vooon/miniecu/README.md

miniECU
=======

miniECU - monitoring unit for model gasoline engines with kill switch.

TBD
