vooon/miniecu/tests/readme.md

Test data
=========

Flow test
---------

Tested on water, 10 cm^3 with two different height.
Time for h1: ~12 sec, h2: ~9 sec.

Calculated flow: 10/12 = 0.8(3) ml/s & 10/9 = 1.1(1) ml/s
