vooon/miniecu/tests/flow_h1_1.csv

# Date: 2014-10-31 10:39:24 | Name: flow test 1
engine_id | system_time | timestamp_ms | status | rpm | battery.voltage | battery.current | battery.remaining | temperature.engine1 | temperature.engine2 | time.total_elapsed | time.current_powered | cpu.load | cpu.temperature | cpu.rtc_vbat | fuel.flow_ml | fuel.total_used_ml | fuel.remaining | adc_raw.flt_temp | adc_raw.flt_oilp | adc_raw.flt_flow | adc_raw.flt_vbat | adc_raw.flt_vrtc | adc_raw.raw_temp | adc_raw.raw_oilp | adc_raw.raw_flow | adc_raw.raw_vbat | adc_raw.raw_vrtc
1 | 517 | NaN | 0 | 0 | 4992 | NaN | 98 | 22913 | NaN | 0 | 0 | NaN | 25270 | NaN | 0 | 0 | NaN | 1.7287009954452515 | 3.3008718490600586 | 0.7941491007804871 | 4.592803001403809 | 7.700487913098186e-06 | 1.7285282611846924 | 3.2999496459960938 | 0.8032090067863464 | 4.5891828536987305 | 0.0
1 | 619 | NaN | 0 | 0 | 5006 | NaN | 100 | 22911 | NaN | 0 | 0 | NaN | 25317 | NaN | 0 | 0 | NaN | 1.7287904024124146 | 3.3008718490600586 | 0.7945593595504761 | 4.606296062469482 | 3.43914272060708e-11 | 1.729837417602539 | 3.2999496459960938 | 0.8032593131065369 | 4.629214763641357 | 0.0
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
