vooon/miniecu/tests/flow_h1_2.csv

# Date: 2014-10-31 10:40:57 | Name: flow test 2
engine_id | system_time | timestamp_ms | status | rpm | battery.voltage | battery.current | battery.remaining | temperature.engine1 | temperature.engine2 | time.total_elapsed | time.current_powered | cpu.load | cpu.temperature | cpu.rtc_vbat | fuel.flow_ml | fuel.total_used_ml | fuel.remaining | adc_raw.flt_temp | adc_raw.flt_oilp | adc_raw.flt_flow | adc_raw.flt_vbat | adc_raw.flt_vrtc | adc_raw.raw_temp | adc_raw.raw_oilp | adc_raw.raw_flow | adc_raw.raw_vbat | adc_raw.raw_vrtc
1 | 102968 | NaN | 0 | 0 | 5026 | NaN | 100 | 22790 | NaN | 0 | 0 | NaN | 35627 | NaN | 0 | 0 | NaN | 1.7334024906158447 | 3.300661563873291 | 0.6732372045516968 | 4.626361846923828 | 8.529740114227025e-08 | 1.7333623170852661 | 3.2999496459960938 | 0.6949462294578552 | 4.622265815734863 | 0.0
1 | 103070 | NaN | 0 | 0 | 5028 | NaN | 100 | 22791 | NaN | 0 | 0 | NaN | 35614 | NaN | 160667 | 0 | NaN | 1.733271837234497 | 3.3006627559661865 | 0.8349511027336121 | 4.628504276275635 | -1.3289600353743313e-17 | 1.7342686653137207 | 3.2999496459960938 | 0.8580453395843506 | 4.594168186187744 | 0.0
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
