vooon/miniecu/tests/flow_h1_3.csv

# Date: 2014-10-31 10:42:09 | Name: flow test 3
engine_id | system_time | timestamp_ms | status | rpm | battery.voltage | battery.current | battery.remaining | temperature.engine1 | temperature.engine2 | time.total_elapsed | time.current_powered | cpu.load | cpu.temperature | cpu.rtc_vbat | fuel.flow_ml | fuel.total_used_ml | fuel.remaining | adc_raw.flt_temp | adc_raw.flt_oilp | adc_raw.flt_flow | adc_raw.flt_vbat | adc_raw.flt_vrtc | adc_raw.raw_temp | adc_raw.raw_oilp | adc_raw.raw_flow | adc_raw.raw_vbat | adc_raw.raw_vrtc
1 | 157945 | NaN | 0 | 0 | 5027 | NaN | 100 | 22623 | NaN | 0 | 0 | NaN | 36032 | NaN | 0 | 0 | NaN | 1.7396252155303955 | 3.300663471221924 | 0.7051165699958801 | 4.627535343170166 | 1.8904756296201318e-17 | 1.737994909286499 | 3.2999496459960938 | 0.6789333820343018 | 4.623776435852051 | 0.0
1 | 158046 | NaN | 0 | 0 | 4992 | NaN | 98 | 22633 | NaN | 0 | 0 | NaN | 36155 | NaN | 251837 | 0 | NaN | 1.7392842769622803 | 3.300663471221924 | 0.881591260433197 | 4.592129707336426 | -3.1687468675465486e-15 | 1.7371388673782349 | 3.2999496459960938 | 0.8919340372085571 | 4.586312770843506 | 0.0
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
