vooon/miniecu/tests/flow_h2_1.csv

# Date: 2014-10-31 10:43:16 | Name: flow test h2 1
engine_id | system_time | timestamp_ms | status | rpm | battery.voltage | battery.current | battery.remaining | temperature.engine1 | temperature.engine2 | time.total_elapsed | time.current_powered | cpu.load | cpu.temperature | cpu.rtc_vbat | fuel.flow_ml | fuel.total_used_ml | fuel.remaining | adc_raw.flt_temp | adc_raw.flt_oilp | adc_raw.flt_flow | adc_raw.flt_vbat | adc_raw.flt_vrtc | adc_raw.raw_temp | adc_raw.raw_oilp | adc_raw.raw_flow | adc_raw.raw_vbat | adc_raw.raw_vrtc
1 | 215214 | NaN | 0 | 0 | 5032 | NaN | 100 | 22598 | NaN | 0 | 0 | NaN | 36187 | NaN | 566455 | 0 | NaN | 1.740506649017334 | 3.30065655708313 | 1.2237610816955566 | 4.632783889770508 | 1.0591588370245653e-11 | 1.7414190769195557 | 3.2999496459960938 | 1.1835888624191284 | 4.633293628692627 | 0.0
1 | 215316 | NaN | 0 | 0 | 5007 | NaN | 100 | 22602 | NaN | 0 | 0 | NaN | 36224 | NaN | 489495 | 0 | NaN | 1.7402788400650024 | 3.300661563873291 | 1.1306991577148438 | 4.6070237159729 | 4.3517224546096855e-11 | 1.7406134605407715 | 3.2999496459960938 | 1.1182284355163574 | 4.59930419921875 | 0.0
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
