vooon/miniecu/tests/flow_h2_2.csv

# Date: 2014-10-31 10:44:24 | Name: flow test h2 2
engine_id | system_time | timestamp_ms | status | rpm | battery.voltage | battery.current | battery.remaining | temperature.engine1 | temperature.engine2 | time.total_elapsed | time.current_powered | cpu.load | cpu.temperature | cpu.rtc_vbat | fuel.flow_ml | fuel.total_used_ml | fuel.remaining | adc_raw.flt_temp | adc_raw.flt_oilp | adc_raw.flt_flow | adc_raw.flt_vbat | adc_raw.flt_vrtc | adc_raw.raw_temp | adc_raw.raw_oilp | adc_raw.raw_flow | adc_raw.raw_vbat | adc_raw.raw_vrtc
1 | 286735 | NaN | 0 | 0 | 4994 | NaN | 98 | 22613 | NaN | 0 | 0 | NaN | 35937 | NaN | 0 | 0 | NaN | 1.739984393119812 | 3.300666570663452 | 0.7632520794868469 | 4.594229221343994 | 1.431556739817097e-07 | 1.7410162687301636 | 3.2999496459960938 | 0.7833691835403442 | 4.597038269042969 | 0.0
1 | 286836 | NaN | 0 | 0 | 4996 | NaN | 99 | 22613 | NaN | 0 | 0 | NaN | 35957 | NaN | 0 | 0 | NaN | 1.7399955987930298 | 3.300658702850342 | 0.7743771076202393 | 4.596792697906494 | 3.2031418262159356e-14 | 1.741117000579834 | 3.2999496459960938 | 0.7913756370544434 | 4.597944736480713 | 0.0
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
