vooon/miniecu/tests/flow_h2_3.csv

# Date: 2014-10-31 10:45:27 | Name: flow test h2 3
engine_id | system_time | timestamp_ms | status | rpm | battery.voltage | battery.current | battery.remaining | temperature.engine1 | temperature.engine2 | time.total_elapsed | time.current_powered | cpu.load | cpu.temperature | cpu.rtc_vbat | fuel.flow_ml | fuel.total_used_ml | fuel.remaining | adc_raw.flt_temp | adc_raw.flt_oilp | adc_raw.flt_flow | adc_raw.flt_vbat | adc_raw.flt_vrtc | adc_raw.raw_temp | adc_raw.raw_oilp | adc_raw.raw_flow | adc_raw.raw_vbat | adc_raw.raw_vrtc
1 | 349792 | NaN | 0 | 0 | 4991 | NaN | 97 | 22720 | NaN | 0 | 0 | NaN | 36045 | NaN | 268119 | 0 | NaN | 1.7359936237335205 | 3.3006627559661865 | 0.8907217979431152 | 4.591337203979492 | 1.2534493976090744e-07 | 1.7357792854309082 | 3.2999496459960938 | 0.9075440168380737 | 4.587521076202393 | 0.0016117215855047107
1 | 349894 | NaN | 0 | 0 | 5028 | NaN | 100 | 22712 | NaN | 0 | 0 | NaN | 35876 | NaN | 225253 | 0 | NaN | 1.7363635301589966 | 3.3006603717803955 | 0.8933573961257935 | 4.628243923187256 | 1.0359529206693807e-11 | 1.736585021018982 | 3.2999496459960938 | 0.8858914971351624 | 4.62589168548584 | 0.0
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
