vooon/miniecu/doc/gtkgauge-test.png

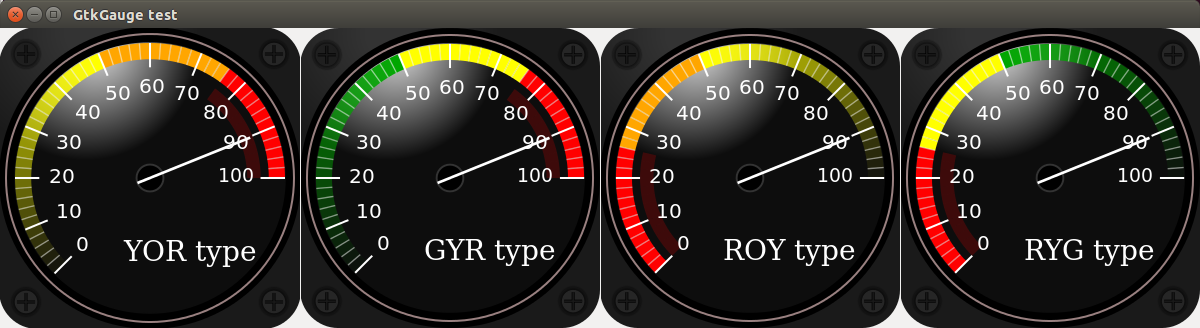
doc/gtkgauge-test.png
