vooon/miniecu/hw/release/miniecu-v2.0a.brd

## EAGLE design hw/release/miniecu-v2.0a.brd (2014-03-09)

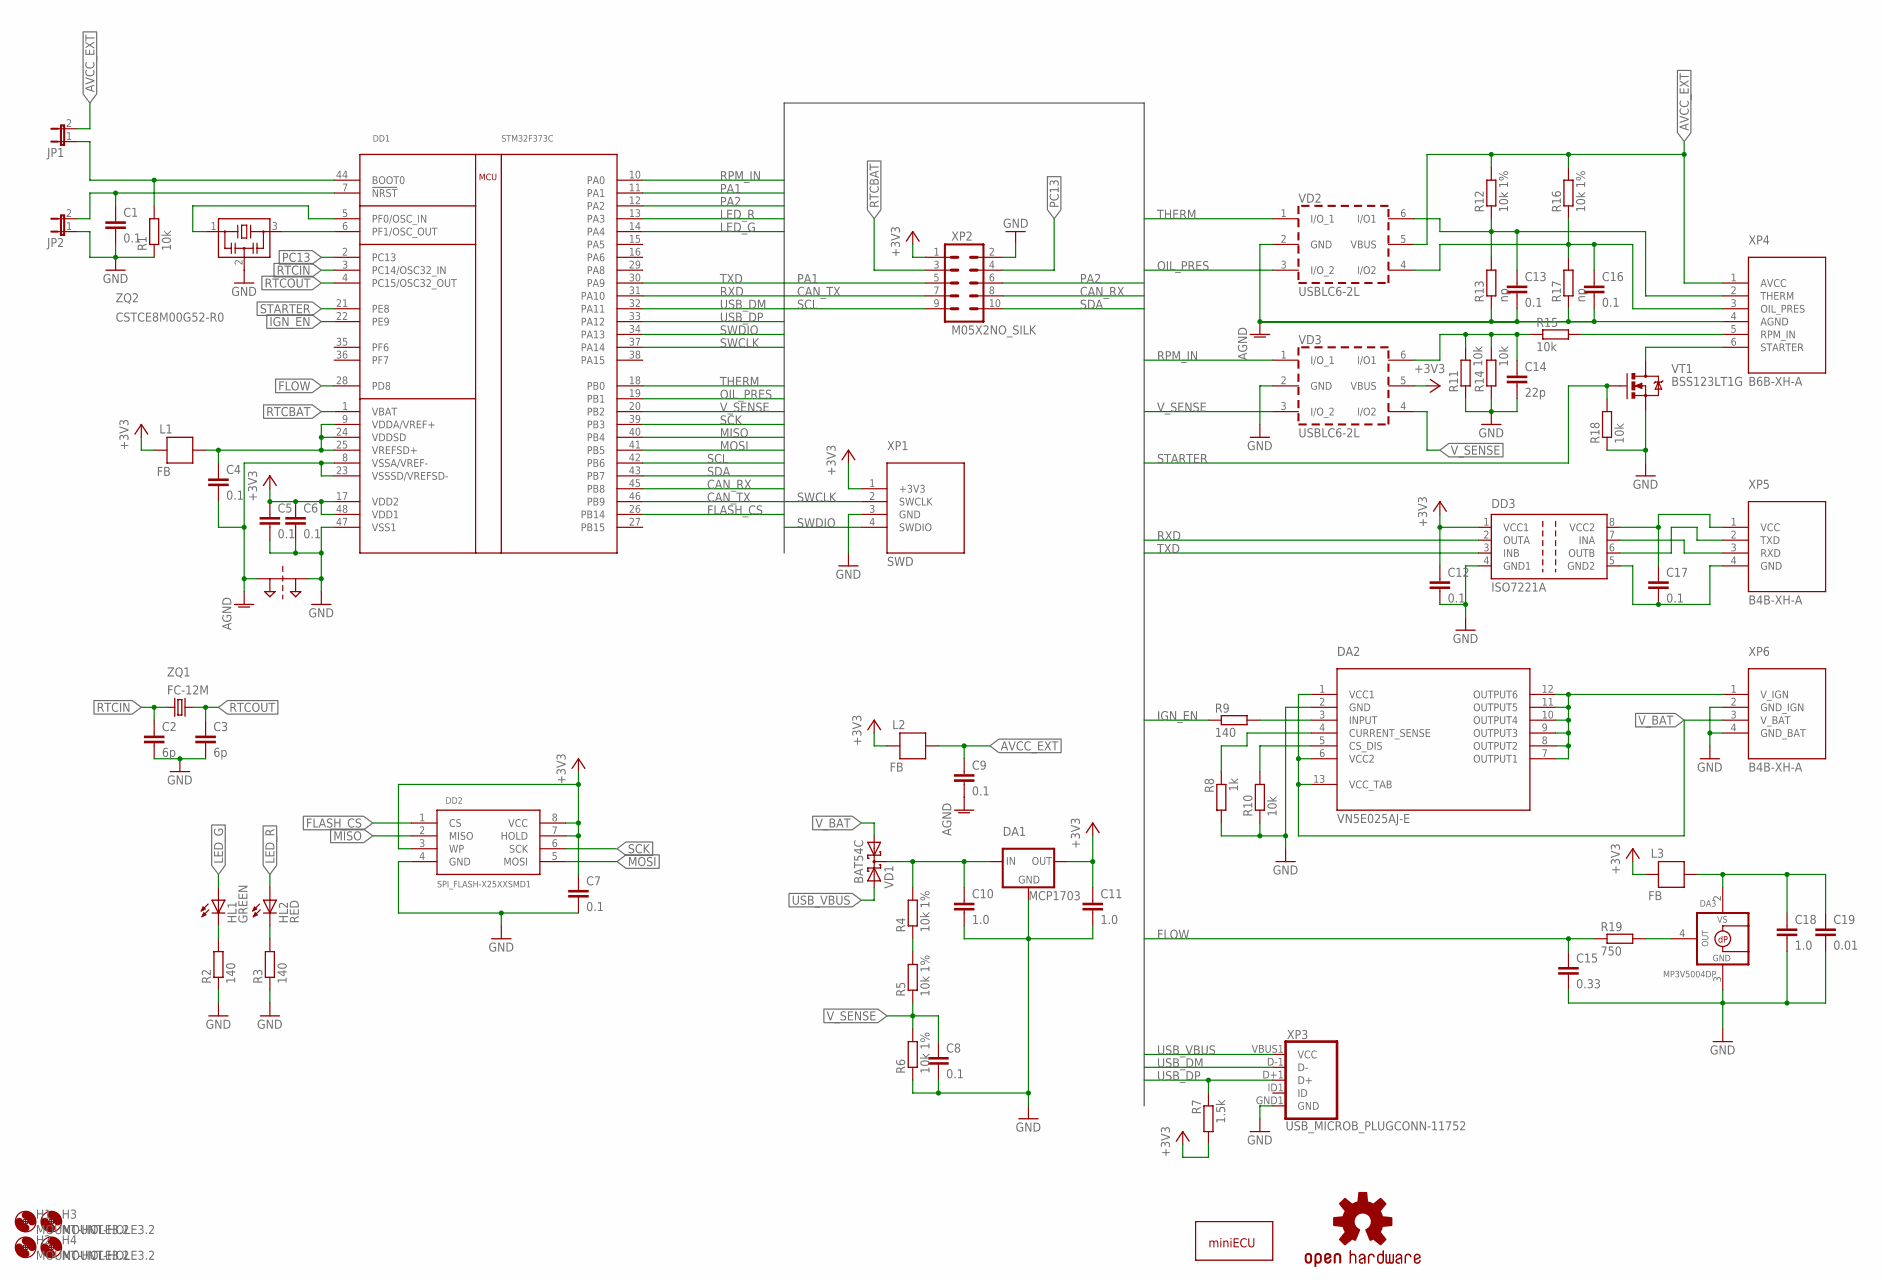
[picture p2: schematic miniecu-v2.0a.sch]

Parts:
C1, C4, C5, C6, C7, C8, C9, C12, C13, C16, C17: 0.1; C0603
C2, C3: 6p; C0603
C10, C11, C18: 1.0; C0805
C14: 22p; C0603
C15: 0.33; C0603
C19: 0.01; C0603
DA1: MCP1703; SOT23
DA2: VN5E025AJ-E; POWERSSO-12
DA3: MP3V5004DP; SOP8-1351
DD1: STM32F373C; LQFP48
DD2: SPI_FLASH-X25XXSMD1; SO08-EIAJ
DD3: ISO7221A; SO-08
H1, H2, H3, H4: MOUNT-HOLE3.2; 3,2
HL1: GREEN; LED-0603
HL2: RED; LED-0603
JP1, JP2: JUMPER-2SMD-NO; SJ_2S-NO
L1, L2, L3: FB; 0603
LOGO1: MINIECU_LOGO
LOGO2: OSHW-LOGOL; OSHW-LOGO-L
PT1: 2PT_GND_TIE
R1, R10, R11, R14, R15, R18: 10k; R0603
R2, R3, R9: 140; R0603
R4, R5, R6, R12, R16: 10k 1%; R0805
R7: 1.5k; R0603
R8: 1k; R0603
R13, R17: np; R0805
R19: 750; R0603
VD1: BAT54C; SOT23
VD2, VD3: USBLC6-2L; SOT-23-6L
VT1: BSS123LT1G; SOT23
XP1: SWD; 1X04-1.27MM
XP2: M05X2NO_SILK; 2X5_NOSILK
XP3: USB_MICROB_PLUGCONN-11752; USB-B-MICRO-SMD_V03
XP4: B6B-XH-A; B6B-XH
XP5, XP6: B4B-XH-A; B4B-XH
ZQ1: FC-12M
ZQ2: CSTCE8M00G52-R0; CSTCE

Connections:
!NRST: C1.1, DD1.7 (!NRST), JP2.2
+3V3: C5.1, C6.1, C7.1, C11.1, C12.1, DA1.2 (OUT), DD1.17 (VDD2), DD1.48 (VDD1), DD2.3 (WP), DD2.7 (HOLD), DD2.8 (VCC), DD3.1 (VCC1), L1.2, L2.2, L3.2, R7.2, VD3.5 (VBUS), XP1.1 (+3V3), XP2.1
AGND: C4.2, C9.2, C13.2, C16.2, DD1.8 (VSSA/VREF-), DD1.23 (VSSSD/VREFSD-), PT1.P$1, R13.1, R17.1, VD2.2 (GND), XP4.4 (AGND)
AVCC: C4.1, DD1.9 (VDDA/VREF+), DD1.24 (VDDSD), DD1.25 (VREFSD+), L1.1
AVCC_EXT: C9.1, JP1.2, L2.1, R12.2, R16.2, VD2.5 (VBUS), XP4.1 (AVCC)
AVCC_FLOW: C18.1, C19.1, DA3.2 (VS), L3.1
BOOT0: DD1.44 (BOOT0), JP1.1, R1.2
CAN_RX: DD1.45 (PB8), XP2.8
CAN_TX: DD1.46 (PB9), XP2.7
FLASH_CS: DD1.26 (PB14), DD2.1 (CS)
FLOW: C15.1, DD1.28 (PD8), R19.1
GND: C1.2, C2.2, C3.2, C5.2, C6.2, C7.2, C8.2, C10.2, C11.2, C12.2, C14.2, C15.2, C18.2, C19.2, DA1.1 (GND), DA2.2 (GND), DA3.3 (GND), DD1.47 (VSS1), DD2.4 (GND), DD3.4 (GND1), JP2.1, PT1.P$2, R1.1, R2.1, R3.1, R6.1, R8.2, R10.1, R11.1, R14.1, R18.1, VD3.2 (GND), VT1.2 (S), XP1.3 (GND), XP2.2, XP3.GND1 (GND), XP6.2 (GND_IGN), XP6.4 (GND_BAT), ZQ2.2
GND2: C17.2, DD3.5 (GND2), XP5.4 (GND)
IGN_EN: DD1.22 (PE9), R9.1
IORXD: DD3.7 (INA), XP5.3 (RXD)
IOTXD: DD3.6 (OUTB), XP5.2 (TXD)
LED_G: DD1.14 (PA4), HL1.A
LED_R: DD1.13 (PA3), HL2.A
MISO: DD1.40 (PB4), DD2.2 (MISO)
MOSI: DD1.41 (PB5), DD2.5 (MOSI)
unnamed: R4.1, R5.2
unnamed: DA2.4 (CURRENT_SENSE), R8.1
unnamed: HL2.C, R3.2
unnamed: DA3.4 (+VOUT), R19.2
unnamed: HL1.C, R2.2
unnamed: C10.1, DA1.3 (IN), R4.2, VD1.3 (CC)
unnamed: DA2.3 (INPUT), R9.2
unnamed: DA2.5 (CS_DIS), R10.2
OIL_PRES: C16.1, DD1.19 (PB1), R16.1, R17.2, VD2.3 (I/O_2), VD2.4 (I/O2), XP4.3 (OIL_PRES)
OSC_IN: DD1.5 (PF0/OSC_IN), ZQ2.1
OSC_OUT: DD1.6 (PF1/OSC_OUT), ZQ2.3
PA1: DD1.11 (PA1), XP2.5
PA2: DD1.12 (PA2), XP2.6
PC13: DD1.2 (PC13), XP2.4
RPM_IN: C14.1, DD1.10 (PA0), R11.2, R14.2, R15.1, VD3.1 (I/O_1), VD3.6 (I/O1)
RPM_IN_CON: R15.2, XP4.5 (RPM_IN)
RTCBAT: DD1.1 (VBAT), XP2.3
RTCIN: C2.1, DD1.3 (PC14/OSC32_IN), ZQ1.1
RTCOUT: C3.1, DD1.4 (PC15/OSC32_OUT), ZQ1.2
RXD: DD1.31 (PA10), DD3.2 (OUTA)
SCK: DD1.39 (PB3), DD2.6 (SCK)
SCL: DD1.42 (PB6), XP2.9
SDA: DD1.43 (PB7), XP2.10
STARTER: DD1.21 (PE8), R18.2, VT1.1 (G)
STARTER_OUT: VT1.3 (D), XP4.6 (STARTER)
SWCLK: DD1.37 (PA14), XP1.2 (SWCLK)
SWDIO: DD1.34 (PA13), XP1.4 (SWDIO)
THERM: C13.1, DD1.18 (PB0), R12.1, R13.2, VD2.1 (I/O_1), VD2.6 (I/O1), XP4.2 (THERM)
TXD: DD1.30 (PA9), DD3.3 (INB)
USB_DM: DD1.32 (PA11), XP3.D-1 (D-)
USB_DP: DD1.33 (PA12), R7.1, XP3.D+1 (D+)
USB_VBUS: VD1.2 (A2), XP3.VBUS1 (VCC)
VCC2: C17.1, DD3.8 (VCC2), XP5.1 (VCC)
V_BAT: DA2.1 (VCC1), DA2.6 (VCC2), DA2.13 (VCC_TAB), VD1.1 (A1), XP6.3 (V_BAT)
V_IGN: DA2.7 (OUTPUT1), DA2.8 (OUTPUT2), DA2.9 (OUTPUT3), DA2.10 (OUTPUT4), DA2.11 (OUTPUT5), DA2.12 (OUTPUT6), XP6.1 (V_IGN)
V_SENSE: C8.1, DD1.20 (PB2), R5.1, R6.2, VD3.3 (I/O_2), VD3.4 (I/O2)

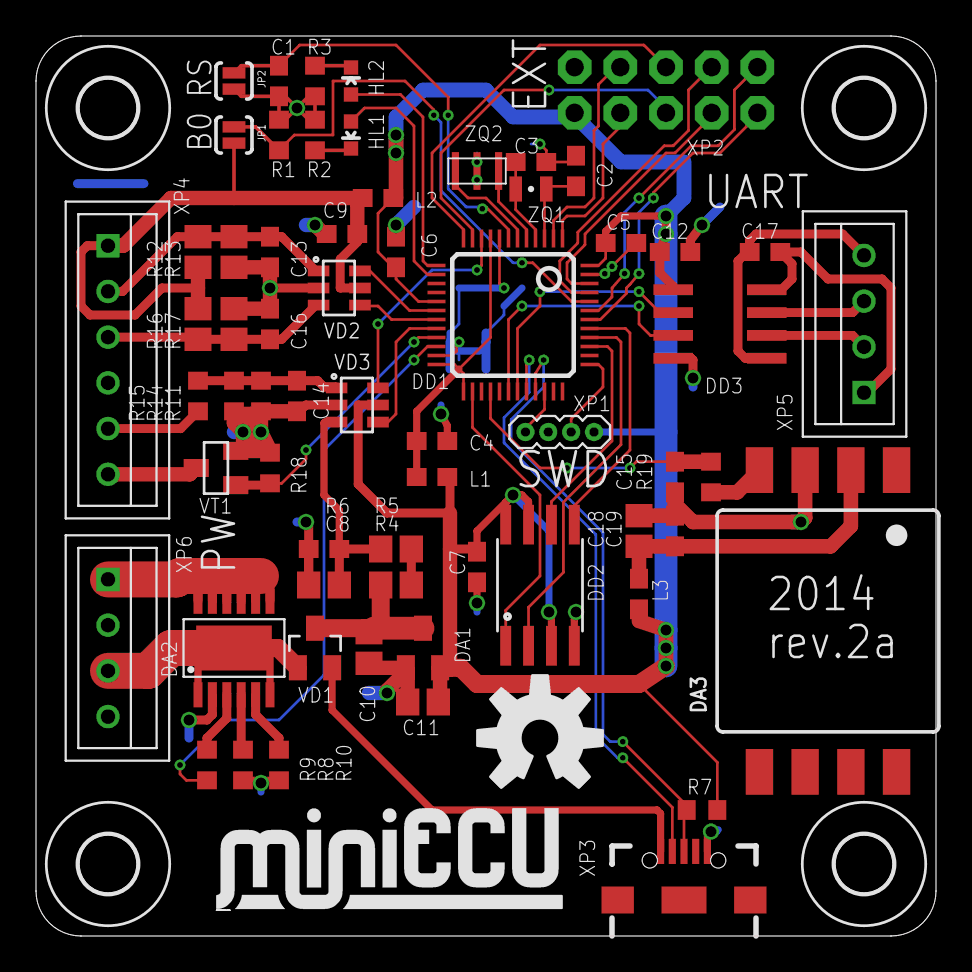
[picture p3: board miniecu-v2.0a.brd from above]

Board: 2 copper layers, 50.0 x 50.0 mm, 70 parts (1 on the bottom side), 56 nets.
