vooon/miniecu/hw/release/miniecu-v1.0c.brd

## EAGLE design hw/release/miniecu-v1.0c.brd (2014-01-30)

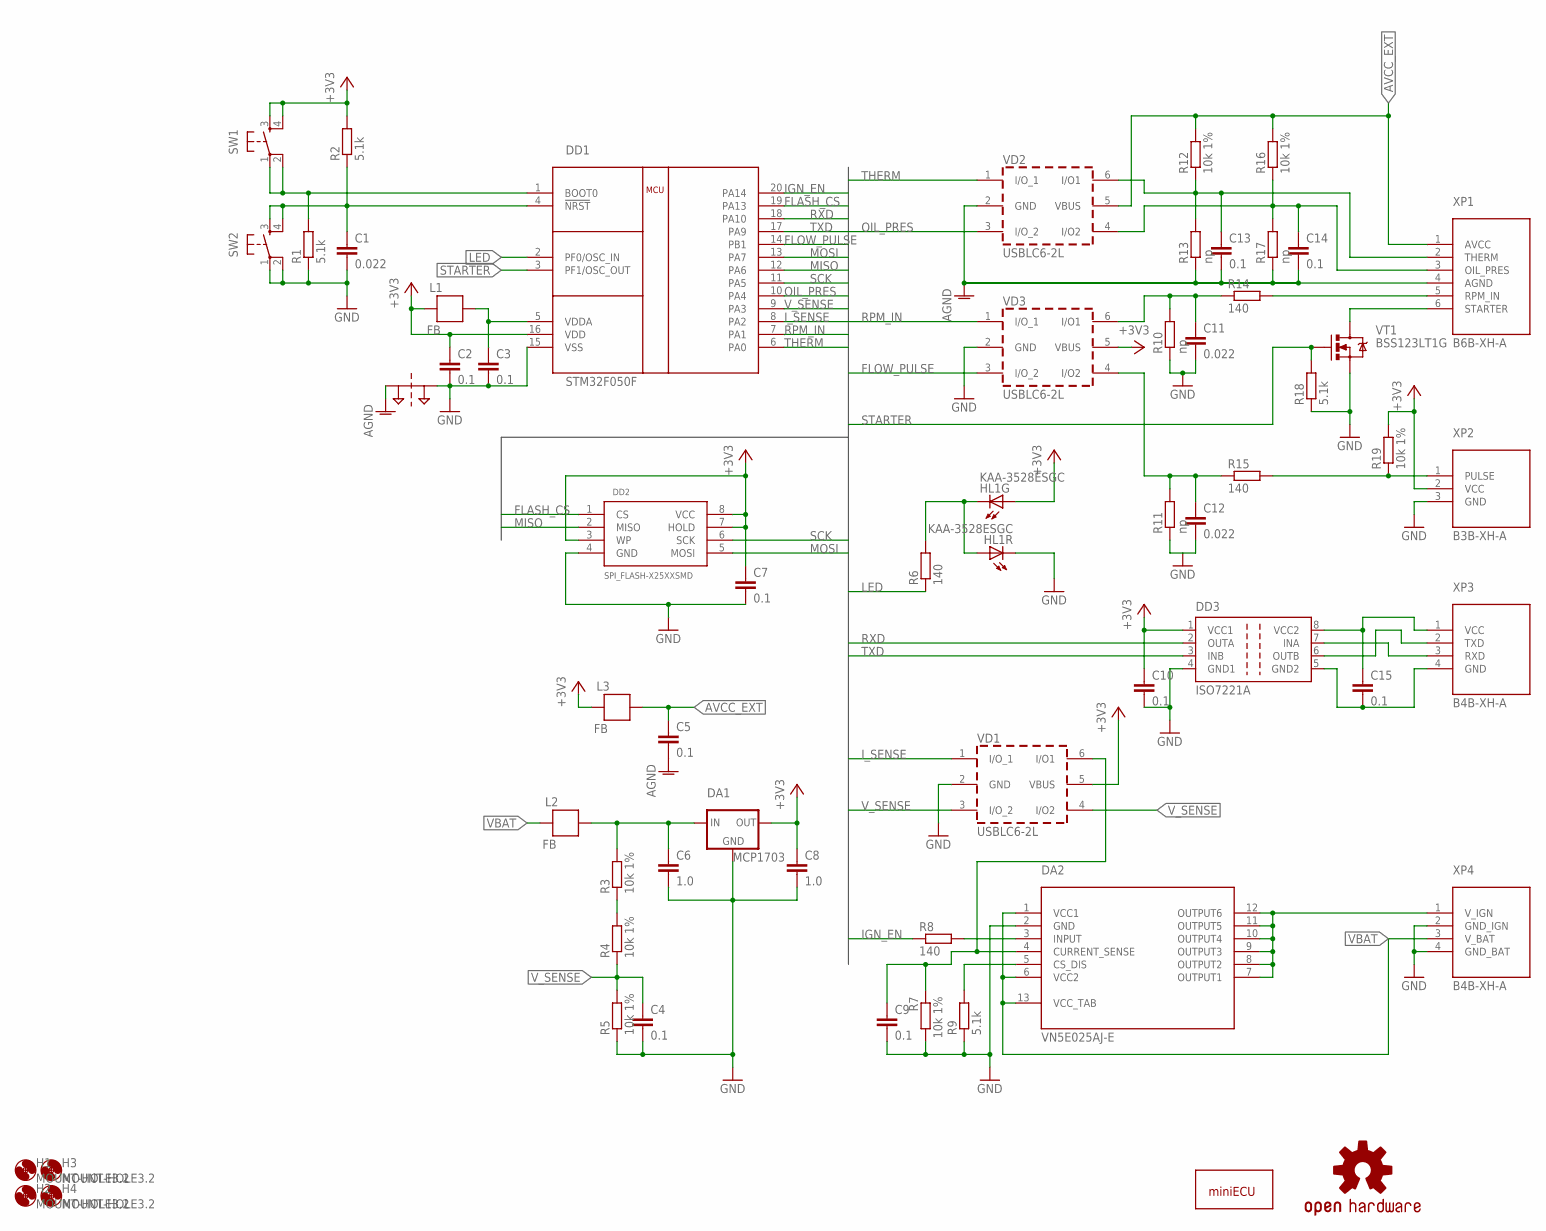
[picture p4: schematic miniecu-v1.0c.sch]

Parts:
C1, C11, C12: 0.022; C0603
C2, C3, C4, C5, C7, C9, C10, C13, C14, C15: 0.1; C0603
C6, C8: 1.0; C0805
DA1: MCP1703; SOT23
DA2: VN5E025AJ-E; POWERSSO-12
DD1: STM32F050F; TSSOP20
DD2: SPI_FLASH-X25XXSMD; SO08
DD3: ISO7221A; SO-08
H1, H2, H3, H4: MOUNT-HOLE3.2; 3,2
HL1: KAA-3528ESGC; KA-3528
L1, L2, L3: FB; 0603
LOGO1: OSHW-LOGOL; OSHW-LOGO-L
LOGO2: MINIECU_LOGO
PT1: 2PT_GND_TIE
R1, R2, R9, R18: 5.1k; R0603
R3, R4, R5, R7, R12, R16, R19: 10k 1%; R0805
R6, R8, R14, R15: 140; R0603
R10, R11: np; R0603
R13, R17: np; R0805
SW1, SW2: TAC_SWITCHSMD; TACTILE_SWITCH_SMD
VD1, VD2, VD3: USBLC6-2L; SOT-23-6L
VT1: BSS123LT1G; SOT23
XP1: B6B-XH-A; B6B-XH
XP2: B3B-XH-A; B3B-XH
XP3, XP4: B4B-XH-A; B4B-XH

Connections:
!NRST: C1.1, DD1.4 (!NRST), R2.1, SW2.3, SW2.4
+3V3: C2.1, C7.1, C8.1, C10.1, DA1.2 (OUT), DD1.16 (VDD), DD2.3 (WP), DD2.7 (HOLD), DD2.8 (VCC), DD3.1 (VCC1), HL1.4 (A), L1.2, L3.2, R2.2, R19.2, SW1.3, SW1.4, VD1.5 (VBUS), VD3.5 (VBUS), XP2.2 (VCC)
AGND: C5.2, C13.2, C14.2, PT1.P$1, R13.1, R17.1, VD2.2 (GND), XP1.4 (AGND)
AVCC: C3.1, DD1.5 (VDDA), L1.1
AVCC_EXT: C5.1, L3.1, R12.2, R16.2, VD2.5 (VBUS), XP1.1 (AVCC)
BOOT0: DD1.1 (BOOT0), R1.2, SW1.1, SW1.2
FLASH_CS: DD1.19 (PA13), DD2.1 (CS)
FLOW_PULSE: C12.1, DD1.14 (PB1), R11.2, R15.1, VD3.3 (I/O_2), VD3.4 (I/O2)
GND: C1.2, C2.2, C3.2, C4.2, C6.2, C7.2, C8.2, C9.2, C10.2, C11.2, C12.2, DA1.1 (GND), DA2.2 (GND), DD1.15 (VSS), DD2.4 (GND), DD3.4 (GND1), HL1.1 (C), PT1.P$2, R1.1, R5.1, R7.2, R9.1, R10.1, R11.1, R18.1, SW2.1, SW2.2, VD1.2 (GND), VD3.2 (GND), VT1.2 (S), XP2.3 (GND), XP4.2 (GND_IGN), XP4.4 (GND_BAT)
GND2: C15.2, DD3.5 (GND2), XP3.4 (GND)
IGN_EN: DD1.20 (PA14), R8.1
IORXD: DD3.7 (INA), XP3.3 (RXD)
IOTXD: DD3.6 (OUTB), XP3.2 (TXD)
I_SENSE: C9.1, DA2.4 (CURRENT_SENSE), DD1.8 (PA2), R7.1, VD1.1 (I/O_1), VD1.6 (I/O1)
LED: DD1.2 (PF0/OSC_IN), R6.1
MISO: DD1.12 (PA6), DD2.2 (MISO)
MOSI: DD1.13 (PA7), DD2.5 (MOSI)
unnamed: R3.1, R4.2
unnamed: HL1.2 (A), HL1.3 (C), R6.2
unnamed: R15.2, R19.1, XP2.1 (PULSE)
unnamed: C6.1, DA1.3 (IN), L2.1, R3.2
unnamed: DA2.3 (INPUT), R8.2
unnamed: DA2.5 (CS_DIS), R9.2
OIL_PRES: C14.1, DD1.10 (PA4), R16.1, R17.2, VD2.3 (I/O_2), VD2.4 (I/O2), XP1.3 (OIL_PRES)
RPM_IN: C11.1, DD1.7 (PA1), R10.2, R14.1, VD3.1 (I/O_1), VD3.6 (I/O1)
RPM_IN_CON: R14.2, XP1.5 (RPM_IN)
RXD: DD1.18 (PA10), DD3.2 (OUTA)
SCK: DD1.11 (PA5), DD2.6 (SCK)
STARTER: DD1.3 (PF1/OSC_OUT), R18.2, VT1.1 (G)
STARTER_OUT: VT1.3 (D), XP1.6 (STARTER)
THERM: C13.1, DD1.6 (PA0), R12.1, R13.2, VD2.1 (I/O_1), VD2.6 (I/O1), XP1.2 (THERM)
TXD: DD1.17 (PA9), DD3.3 (INB)
VBAT: DA2.1 (VCC1), DA2.6 (VCC2), DA2.13 (VCC_TAB), L2.2, XP4.3 (V_BAT)
VCC2: C15.1, DD3.8 (VCC2), XP3.1 (VCC)
V_IGN: DA2.7 (OUTPUT1), DA2.8 (OUTPUT2), DA2.9 (OUTPUT3), DA2.10 (OUTPUT4), DA2.11 (OUTPUT5), DA2.12 (OUTPUT6), XP4.1 (V_IGN)
V_SENSE: C4.1, DD1.9 (PA3), R4.1, R5.2, VD1.3 (I/O_2), VD1.4 (I/O2)

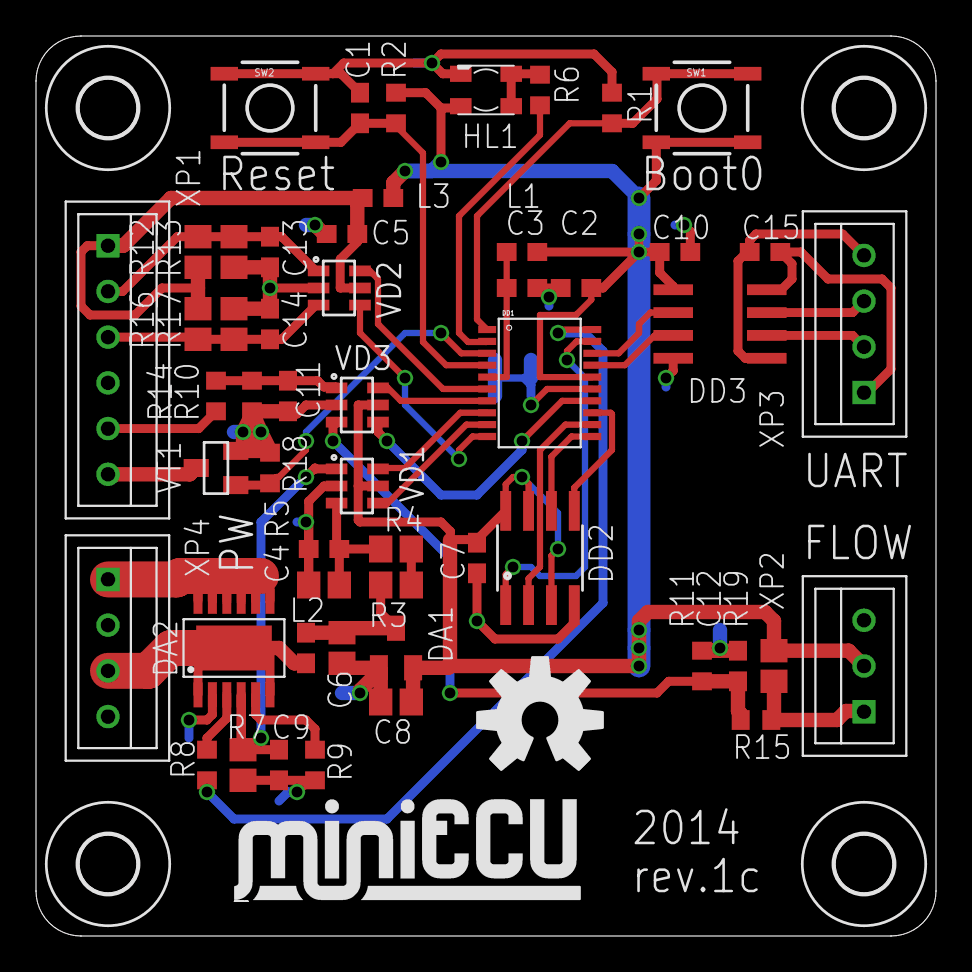
[picture p5: board miniecu-v1.0c.brd from above]

Board: 2 copper layers, 50.0 x 50.0 mm, 60 parts (1 on the bottom side), 36 nets.
