vooon/miniecu/boards/miniecu_v2/board.h

/*
    ChibiOS/RT - Copyright (C) 2006-2014 Giovanni Di Sirio

    Licensed under the Apache License, Version 2.0 (the "License");
    you may not use this file except in compliance with the License.
    You may obtain a copy of the License at

        http://www.apache.org/licenses/LICENSE-2.0

    Unless required by applicable law or agreed to in writing, software
    distributed under the License is distributed on an "AS IS" BASIS,
    WITHOUT WARRANTIES OR CONDITIONS OF ANY KIND, either express or implied.
    See the License for the specific language governing permissions and
    limitations under the License.
*/

#ifndef _BOARD_H_
#define _BOARD_H_

/*
 * Setup for miniECU board.
 */

#include "fw_config.h"

/*
 * Board identifier.
 */
#define BOARD_MINIECU_V2
#define BOARD_NAME                  "miniECU v2"

/*
 * Board oscillators-related settings.
 */
#if !defined(STM32_LSECLK)
#define STM32_LSECLK                32768
#endif

#define STM32_LSEDRV                (3 << 3)

#if !defined(STM32_HSECLK)
#define STM32_HSECLK                8000000
#endif

/*
 * MCU type as defined in the ST header.
 */
#define STM32F373xC

/*
 * IO pins assignments.
 */
#define GPIOA_RPM_IN                0
#define GPIOA_XP2_PA1               1
#define GPIOA_XP2_PA2               2
#define GPIOA_LED_R                 3
#define GPIOA_LED_G                 4
#define GPIOA_PIN5                  5
#define GPIOA_PIN6                  6
#define GPIOA_PIN7                  7
#define GPIOA_PIN8                  8
#define GPIOA_USART1_TX             9
#define GPIOA_USART1_RX             10
#define GPIOA_USB_DM                11
#define GPIOA_USB_DP                12
#define GPIOA_SWDIO                 13
#define GPIOA_SWCLK                 14
#define GPIOA_PIN15                 15

#define GPIOB_THERM                 0
#define GPIOB_OIL_PRES              1
#define GPIOB_V_SENSE               2
#define GPIOB_SPI1_SCK              3
#define GPIOB_SPI1_MISO             4
#define GPIOB_SPI1_MOSI             5
#define GPIOB_I2C1_SCL              6
#define GPIOB_I2C1_SDA              7
#define GPIOB_CAN_RX                8
#define GPIOB_CAN_TX                9
#define GPIOB_PIN10                 10
#define GPIOB_PIN11                 11
#define GPIOB_PIN12                 12
#define GPIOB_PIN13                 13
#define GPIOB_FLASH_CS              14
#define GPIOB_PIN15                 15

#define GPIOC_PIN0                  0
#define GPIOC_PIN1                  1
#define GPIOC_PIN2                  2
#define GPIOC_PIN3                  3
#define GPIOC_PIN4                  4
#define GPIOC_PIN5                  5
#define GPIOC_PIN6                  6
#define GPIOC_PIN7                  7
#define GPIOC_PIN8                  8
#define GPIOC_PIN9                  9
#define GPIOC_PIN10                 10
#define GPIOC_PIN11                 11
#define GPIOC_PIN12                 12
#define GPIOC_XP2_PC13              13
#define GPIOC_OSC32_IN              14
#define GPIOC_OSC32_OUT             15

#define GPIOD_PIN0                  0
#define GPIOD_PIN1                  1
#define GPIOD_PIN2                  2
#define GPIOD_PIN3                  3
#define GPIOD_PIN4                  4
#define GPIOD_PIN5                  5
#define GPIOD_PIN6                  6
#define GPIOD_PIN7                  7
#define GPIOD_FLOW                  8
#define GPIOD_PIN9                  9
#define GPIOD_PIN10                 10
#define GPIOD_PIN11                 11
#define GPIOD_PIN12                 12
#define GPIOD_PIN13                 13
#define GPIOD_PIN14                 14
#define GPIOD_PIN15                 15

#define GPIOE_PIN0                  0
#define GPIOE_PIN1                  1
#define GPIOE_PIN2                  2
#define GPIOE_PIN3                  3
#define GPIOE_PIN4                  4
#define GPIOE_PIN5                  5
#define GPIOE_PIN6                  6
#define GPIOE_PIN7                  7
#define GPIOE_STARTER               8
#define GPIOE_IGN_EN                9
#define GPIOE_PIN10                 10
#define GPIOE_PIN11                 11
#define GPIOE_PIN12                 12
#define GPIOE_PIN13                 13
#define GPIOE_PIN14                 14
#define GPIOE_PIN15                 15

#define GPIOF_OSC_IN                0
#define GPIOF_OSC_OUT               1
#define GPIOF_PIN2                  2
#define GPIOF_PIN3                  3
#define GPIOF_PIN4                  4
#define GPIOF_PIN5                  5
#define GPIOF_PIN6                  6
#define GPIOF_PIN7                  7
#define GPIOF_PIN8                  8
#define GPIOF_PIN9                  9
#define GPIOF_PIN10                 10
#define GPIOF_PIN11                 11
#define GPIOF_PIN12                 12
#define GPIOF_PIN13                 13
#define GPIOF_PIN14                 14
#define GPIOF_PIN15                 15

/*
 * I/O ports initial setup, this configuration is established soon after reset
 * in the initialization code.
 * Please refer to the STM32 Reference Manual for details.
 */
#define PIN_MODE_INPUT(n)           (0U << ((n) * 2))
#define PIN_MODE_OUTPUT(n)          (1U << ((n) * 2))
#define PIN_MODE_ALTERNATE(n)       (2U << ((n) * 2))
#define PIN_MODE_ANALOG(n)          (3U << ((n) * 2))
#define PIN_ODR_LOW(n)              (0U << (n))
#define PIN_ODR_HIGH(n)             (1U << (n))
#define PIN_OTYPE_PUSHPULL(n)       (0U << (n))
#define PIN_OTYPE_OPENDRAIN(n)      (1U << (n))
#define PIN_OSPEED_2M(n)            (0U << ((n) * 2))
#define PIN_OSPEED_25M(n)           (1U << ((n) * 2))
#define PIN_OSPEED_50M(n)           (2U << ((n) * 2))
#define PIN_OSPEED_100M(n)          (3U << ((n) * 2))
#define PIN_PUPDR_FLOATING(n)       (0U << ((n) * 2))
#define PIN_PUPDR_PULLUP(n)         (1U << ((n) * 2))
#define PIN_PUPDR_PULLDOWN(n)       (2U << ((n) * 2))
#define PIN_AFIO_AF(n, v)           ((v##U) << ((n % 8) * 4))

/*
 * GPIOA setup:
 *
 * PA0  - RPM IN                    (alternate 1).
 * PA1  - XP2 PA1                   (def).
 * PA2  - XP2 PA2                   (def).
 * PA3  - LED RED                   (output).
 * PA4  - LED GREEN                 (output).
 * PA5  -                           (def).
 * PA6  -                           (def).
 * PA7  -                           (def).
 * PA8  -                           (def).
 * PA9  - TXD                       (alternate 7).
 * PA10 - RXD                       (alterante 7).
 * PA11 - USB D+                    (alternate 14).
 * PA12 - USB D-                    (alternate 14).
 * PA13 - SWDIO                     (alternate 0).
 * PA14 - SWCLK                     (alternate 0).
 * PA15 -                           (def).
 */
#define VAL_GPIOA_MODER             (PIN_MODE_ALTERNATE(GPIOA_RPM_IN) |     \
                                     PIN_MODE_INPUT(GPIOA_XP2_PA1) |        \
                                     PIN_MODE_INPUT(GPIOA_XP2_PA2) |        \
                                     PIN_MODE_OUTPUT(GPIOA_LED_R) |         \
                                     PIN_MODE_OUTPUT(GPIOA_LED_G) |         \
                                     PIN_MODE_INPUT(GPIOA_PIN5) |           \
                                     PIN_MODE_INPUT(GPIOA_PIN6) |           \
                                     PIN_MODE_INPUT(GPIOA_PIN7) |           \
                                     PIN_MODE_INPUT(GPIOA_PIN8) |           \
                                     PIN_MODE_ALTERNATE(GPIOA_USART1_TX) |  \
                                     PIN_MODE_ALTERNATE(GPIOA_USART1_RX) |  \
                                     PIN_MODE_ALTERNATE(GPIOA_USB_DM) |     \
                                     PIN_MODE_ALTERNATE(GPIOA_USB_DP) |     \
                                     PIN_MODE_ALTERNATE(GPIOA_SWDIO) |      \
                                     PIN_MODE_ALTERNATE(GPIOA_SWCLK) |      \
                                     PIN_MODE_INPUT(GPIOA_PIN15))
#define VAL_GPIOA_OTYPER            (PIN_OTYPE_PUSHPULL(GPIOA_RPM_IN) |     \
                                     PIN_OTYPE_PUSHPULL(GPIOA_XP2_PA1) |    \
                                     PIN_OTYPE_PUSHPULL(GPIOA_XP2_PA2) |    \
                                     PIN_OTYPE_PUSHPULL(GPIOA_LED_R) |      \
                                     PIN_OTYPE_PUSHPULL(GPIOA_LED_G) |      \
                                     PIN_OTYPE_PUSHPULL(GPIOA_PIN5) |       \
                                     PIN_OTYPE_PUSHPULL(GPIOA_PIN6) |       \
                                     PIN_OTYPE_PUSHPULL(GPIOA_PIN7) |       \
                                     PIN_OTYPE_PUSHPULL(GPIOA_PIN8) |       \
                                     PIN_OTYPE_PUSHPULL(GPIOA_USART1_TX) |  \
                                     PIN_OTYPE_PUSHPULL(GPIOA_USART1_RX) |  \
                                     PIN_OTYPE_PUSHPULL(GPIOA_USB_DM) |     \
                                     PIN_OTYPE_PUSHPULL(GPIOA_USB_DP) |     \
                                     PIN_OTYPE_PUSHPULL(GPIOA_SWDIO) |      \
                                     PIN_OTYPE_PUSHPULL(GPIOA_SWCLK) |      \
                                     PIN_OTYPE_PUSHPULL(GPIOA_PIN15))
#define VAL_GPIOA_OSPEEDR           (PIN_OSPEED_100M(GPIOA_RPM_IN) |        \
                                     PIN_OSPEED_2M(GPIOA_XP2_PA1) |         \
                                     PIN_OSPEED_2M(GPIOA_XP2_PA2) |         \
                                     PIN_OSPEED_2M(GPIOA_LED_R) |           \
                                     PIN_OSPEED_2M(GPIOA_LED_G) |           \
                                     PIN_OSPEED_2M(GPIOA_PIN5) |            \
                                     PIN_OSPEED_2M(GPIOA_PIN6) |            \
                                     PIN_OSPEED_2M(GPIOA_PIN7) |            \
                                     PIN_OSPEED_2M(GPIOA_PIN8) |            \
                                     PIN_OSPEED_100M(GPIOA_USART1_TX) |     \
                                     PIN_OSPEED_100M(GPIOA_USART1_RX) |     \
                                     PIN_OSPEED_100M(GPIOA_USB_DM) |        \
                                     PIN_OSPEED_100M(GPIOA_USB_DP) |        \
                                     PIN_OSPEED_100M(GPIOA_SWDIO) |         \
                                     PIN_OSPEED_100M(GPIOA_SWCLK) |         \
                                     PIN_OSPEED_2M(GPIOA_PIN15))
#define VAL_GPIOA_PUPDR             (PIN_PUPDR_FLOATING(GPIOA_RPM_IN) |     \
                                     PIN_PUPDR_PULLUP(GPIOA_XP2_PA1) |      \
                                     PIN_PUPDR_PULLUP(GPIOA_XP2_PA2) |      \
                                     PIN_PUPDR_FLOATING(GPIOA_LED_R) |      \
                                     PIN_PUPDR_FLOATING(GPIOA_LED_G) |      \
                                     PIN_PUPDR_PULLUP(GPIOA_PIN5) |         \
                                     PIN_PUPDR_PULLUP(GPIOA_PIN6) |         \
                                     PIN_PUPDR_PULLUP(GPIOA_PIN7) |         \
                                     PIN_PUPDR_PULLUP(GPIOA_PIN8) |         \
                                     PIN_PUPDR_FLOATING(GPIOA_USART1_TX) |  \
                                     PIN_PUPDR_FLOATING(GPIOA_USART1_RX) |  \
                                     PIN_PUPDR_FLOATING(GPIOA_USB_DM) |     \
                                     PIN_PUPDR_FLOATING(GPIOA_USB_DP) |     \
                                     PIN_PUPDR_PULLUP(GPIOA_SWDIO) |        \
                                     PIN_PUPDR_PULLDOWN(GPIOA_SWCLK) |      \
                                     PIN_PUPDR_PULLUP(GPIOA_PIN15))
#define VAL_GPIOA_ODR               (PIN_ODR_HIGH(GPIOA_RPM_IN) |           \
                                     PIN_ODR_HIGH(GPIOA_XP2_PA1) |          \
                                     PIN_ODR_HIGH(GPIOA_XP2_PA2) |          \
                                     PIN_ODR_HIGH(GPIOA_LED_R) |            \
                                     PIN_ODR_LOW(GPIOA_LED_G) |             \
                                     PIN_ODR_HIGH(GPIOA_PIN5) |             \
                                     PIN_ODR_HIGH(GPIOA_PIN6) |             \
                                     PIN_ODR_HIGH(GPIOA_PIN7) |             \
                                     PIN_ODR_HIGH(GPIOA_PIN8) |             \
                                     PIN_ODR_HIGH(GPIOA_USART1_TX) |        \
                                     PIN_ODR_HIGH(GPIOA_USART1_RX) |        \
                                     PIN_ODR_HIGH(GPIOA_USB_DM) |           \
                                     PIN_ODR_HIGH(GPIOA_USB_DP) |           \
                                     PIN_ODR_HIGH(GPIOA_SWDIO) |            \
                                     PIN_ODR_LOW(GPIOA_SWCLK) |             \
                                     PIN_ODR_HIGH(GPIOA_PIN15))
#define VAL_GPIOA_AFRL              (PIN_AFIO_AF(GPIOA_RPM_IN, 1) |         \
                                     PIN_AFIO_AF(GPIOA_XP2_PA1, 0) |        \
                                     PIN_AFIO_AF(GPIOA_XP2_PA2, 0) |        \
                                     PIN_AFIO_AF(GPIOA_LED_R, 0) |          \
                                     PIN_AFIO_AF(GPIOA_LED_G, 0) |          \
                                     PIN_AFIO_AF(GPIOA_PIN5, 0) |           \
                                     PIN_AFIO_AF(GPIOA_PIN6, 0) |           \
                                     PIN_AFIO_AF(GPIOA_PIN7, 0))
#define VAL_GPIOA_AFRH              (PIN_AFIO_AF(GPIOA_PIN8, 0) |           \
                                     PIN_AFIO_AF(GPIOA_USART1_TX, 7) |      \
                                     PIN_AFIO_AF(GPIOA_USART1_RX, 7) |      \
                                     PIN_AFIO_AF(GPIOA_USB_DM, 14) |        \
                                     PIN_AFIO_AF(GPIOA_USB_DP, 14) |        \
                                     PIN_AFIO_AF(GPIOA_SWDIO, 0) |          \
                                     PIN_AFIO_AF(GPIOA_SWCLK, 0) |          \
                                     PIN_AFIO_AF(GPIOA_PIN15, 0))

/*
 * GPIOB setup:
 *
 * PB0  - THERM                     (analog floating).
 * PB1  - OIL Pessure               (analog floating).
 * PB2  - V Sense                   (analog floating).
 * PB3  - SPI1 SCK                  (alternate 5).
 * PB4  - SPI1 MISO                 (alternate 5).
 * PB5  - SPI1 MOSI                 (alternate 5).
 * PB6  - I2C1 SCL                  (alternate 4).
 * PB7  - I2C1 SDA                  (alternate 4).
 * PB8  - CAN RX                    (alternate 9).
 * PB9  - CAN TX                    (alternate 9).
 * PB10 -                           (def).
 * PB11 -                           (def).
 * PB12 -                           (def).
 * PB13 -                           (def).
 * PB14 - FLASH_CS                  (output up).
 * PB15 -                           (def).
 */
#define VAL_GPIOB_MODER             (PIN_MODE_ANALOG(GPIOB_THERM) |         \
                                     PIN_MODE_ANALOG(GPIOB_OIL_PRES) |      \
                                     PIN_MODE_ANALOG(GPIOB_V_SENSE) |       \
                                     PIN_MODE_ALTERNATE(GPIOB_SPI1_SCK) |   \
                                     PIN_MODE_ALTERNATE(GPIOB_SPI1_MISO) |  \
                                     PIN_MODE_ALTERNATE(GPIOB_SPI1_MOSI) |  \
                                     PIN_MODE_ALTERNATE(GPIOB_I2C1_SCL) |   \
                                     PIN_MODE_ALTERNATE(GPIOB_I2C1_SDA) |   \
                                     PIN_MODE_ALTERNATE(GPIOB_CAN_RX) |     \
                                     PIN_MODE_ALTERNATE(GPIOB_CAN_TX) |     \
                                     PIN_MODE_INPUT(GPIOB_PIN10) |          \
                                     PIN_MODE_INPUT(GPIOB_PIN11) |          \
                                     PIN_MODE_INPUT(GPIOB_PIN12) |          \
                                     PIN_MODE_INPUT(GPIOB_PIN13) |          \
                                     PIN_MODE_OUTPUT(GPIOB_FLASH_CS) |      \
                                     PIN_MODE_INPUT(GPIOB_PIN15))
#define VAL_GPIOB_OTYPER            (PIN_OTYPE_PUSHPULL(GPIOB_THERM) |      \
                                     PIN_OTYPE_PUSHPULL(GPIOB_OIL_PRES) |   \
                                     PIN_OTYPE_PUSHPULL(GPIOB_V_SENSE) |    \
                                     PIN_OTYPE_PUSHPULL(GPIOB_SPI1_SCK) |   \
                                     PIN_OTYPE_PUSHPULL(GPIOB_SPI1_MISO) |  \
                                     PIN_OTYPE_PUSHPULL(GPIOB_SPI1_MOSI) |  \
                                     PIN_OTYPE_OPENDRAIN(GPIOB_I2C1_SCL) |  \
                                     PIN_OTYPE_OPENDRAIN(GPIOB_I2C1_SDA) |  \
                                     PIN_OTYPE_PUSHPULL(GPIOB_CAN_RX) |     \
                                     PIN_OTYPE_PUSHPULL(GPIOB_CAN_TX) |     \
                                     PIN_OTYPE_PUSHPULL(GPIOB_PIN10) |      \
                                     PIN_OTYPE_PUSHPULL(GPIOB_PIN11) |      \
                                     PIN_OTYPE_PUSHPULL(GPIOB_PIN12) |      \
                                     PIN_OTYPE_PUSHPULL(GPIOB_PIN13) |      \
                                     PIN_OTYPE_PUSHPULL(GPIOB_FLASH_CS) |   \
                                     PIN_OTYPE_PUSHPULL(GPIOB_PIN15))
#define VAL_GPIOB_OSPEEDR           (PIN_OSPEED_2M(GPIOB_THERM) |           \
                                     PIN_OSPEED_2M(GPIOB_OIL_PRES) |        \
                                     PIN_OSPEED_2M(GPIOB_V_SENSE) |         \
                                     PIN_OSPEED_100M(GPIOB_SPI1_SCK) |      \
                                     PIN_OSPEED_100M(GPIOB_SPI1_MISO) |     \
                                     PIN_OSPEED_100M(GPIOB_SPI1_MOSI) |     \
                                     PIN_OSPEED_100M(GPIOB_I2C1_SCL) |      \
                                     PIN_OSPEED_100M(GPIOB_I2C1_SDA) |      \
                                     PIN_OSPEED_100M(GPIOB_CAN_RX) |        \
                                     PIN_OSPEED_100M(GPIOB_CAN_TX) |        \
                                     PIN_OSPEED_2M(GPIOB_PIN10) |           \
                                     PIN_OSPEED_2M(GPIOB_PIN11) |           \
                                     PIN_OSPEED_2M(GPIOB_PIN12) |           \
                                     PIN_OSPEED_2M(GPIOB_PIN13) |           \
                                     PIN_OSPEED_100M(GPIOB_FLASH_CS) |      \
                                     PIN_OSPEED_2M(GPIOB_PIN15))
#define VAL_GPIOB_PUPDR             (PIN_PUPDR_FLOATING(GPIOB_THERM) |      \
                                     PIN_PUPDR_FLOATING(GPIOB_OIL_PRES) |   \
                                     PIN_PUPDR_FLOATING(GPIOB_V_SENSE) |    \
                                     PIN_PUPDR_FLOATING(GPIOB_SPI1_SCK) |   \
                                     PIN_PUPDR_PULLUP(GPIOB_SPI1_MISO) |    \
                                     PIN_PUPDR_FLOATING(GPIOB_SPI1_MOSI) |  \
                                     PIN_PUPDR_PULLUP(GPIOB_I2C1_SCL) |     \
                                     PIN_PUPDR_PULLUP(GPIOB_I2C1_SDA) |     \
                                     PIN_PUPDR_FLOATING(GPIOB_CAN_RX) |     \
                                     PIN_PUPDR_FLOATING(GPIOB_CAN_TX) |     \
                                     PIN_PUPDR_PULLUP(GPIOB_PIN10) |        \
                                     PIN_PUPDR_PULLUP(GPIOB_PIN11) |        \
                                     PIN_PUPDR_PULLUP(GPIOB_PIN12) |        \
                                     PIN_PUPDR_PULLUP(GPIOB_PIN13) |        \
                                     PIN_PUPDR_PULLUP(GPIOB_FLASH_CS) |     \
                                     PIN_PUPDR_PULLUP(GPIOB_PIN15))
#define VAL_GPIOB_ODR               (PIN_ODR_HIGH(GPIOB_THERM) |            \
                                     PIN_ODR_HIGH(GPIOB_OIL_PRES) |         \
                                     PIN_ODR_HIGH(GPIOB_V_SENSE) |          \
                                     PIN_ODR_HIGH(GPIOB_SPI1_SCK) |         \
                                     PIN_ODR_HIGH(GPIOB_SPI1_MISO) |        \
                                     PIN_ODR_HIGH(GPIOB_SPI1_MOSI) |        \
                                     PIN_ODR_HIGH(GPIOB_I2C1_SCL) |         \
                                     PIN_ODR_HIGH(GPIOB_I2C1_SDA) |         \
                                     PIN_ODR_HIGH(GPIOB_CAN_RX) |           \
                                     PIN_ODR_HIGH(GPIOB_CAN_TX) |           \
                                     PIN_ODR_HIGH(GPIOB_PIN10) |            \
                                     PIN_ODR_HIGH(GPIOB_PIN11) |            \
                                     PIN_ODR_HIGH(GPIOB_PIN12) |            \
                                     PIN_ODR_HIGH(GPIOB_PIN13) |            \
                                     PIN_ODR_HIGH(GPIOB_FLASH_CS) |         \
                                     PIN_ODR_HIGH(GPIOB_PIN15))
#define VAL_GPIOB_AFRL              (PIN_AFIO_AF(GPIOB_THERM, 0) |          \
                                     PIN_AFIO_AF(GPIOB_OIL_PRES, 0) |       \
                                     PIN_AFIO_AF(GPIOB_V_SENSE, 0) |        \
                                     PIN_AFIO_AF(GPIOB_SPI1_SCK, 5) |       \
                                     PIN_AFIO_AF(GPIOB_SPI1_MISO, 5) |      \
                                     PIN_AFIO_AF(GPIOB_SPI1_MOSI, 5) |      \
                                     PIN_AFIO_AF(GPIOB_I2C1_SCL, 4) |       \
                                     PIN_AFIO_AF(GPIOB_I2C1_SDA, 4))
#define VAL_GPIOB_AFRH              (PIN_AFIO_AF(GPIOB_CAN_RX, 9) |         \
                                     PIN_AFIO_AF(GPIOB_CAN_TX, 9) |         \
                                     PIN_AFIO_AF(GPIOB_PIN10, 0) |          \
                                     PIN_AFIO_AF(GPIOB_PIN11, 0) |          \
                                     PIN_AFIO_AF(GPIOB_PIN12, 0) |          \
                                     PIN_AFIO_AF(GPIOB_PIN13, 0) |          \
                                     PIN_AFIO_AF(GPIOB_FLASH_CS, 0) |       \
                                     PIN_AFIO_AF(GPIOB_PIN15, 0))

/*
 * GPIOC setup:
 *
 * PC0  -                           (def).
 * PC1  -                           (def).
 * PC2  -                           (def).
 * PC3  -                           (def).
 * PC4  -                           (def).
 * PC5  -                           (def).
 * PC6  -                           (def).
 * PC7  -                           (def).
 * PC8  -                           (def).
 * PC9  -                           (def).
 * PC10 -                           (def).
 * PC11 -                           (def).
 * PC12 -                           (def).
 * PC13 - XP2 PC13                  (def).
 * PC14 - OSC32_IN                  (input floating).
 * PC15 - OSC32_OUT                 (input floating).
 */
#define VAL_GPIOC_MODER             (PIN_MODE_INPUT(GPIOC_PIN0) |           \
                                     PIN_MODE_INPUT(GPIOC_PIN1) |           \
                                     PIN_MODE_INPUT(GPIOC_PIN2) |           \
                                     PIN_MODE_INPUT(GPIOC_PIN3) |           \
                                     PIN_MODE_INPUT(GPIOC_PIN4) |           \
                                     PIN_MODE_INPUT(GPIOC_PIN5) |           \
                                     PIN_MODE_INPUT(GPIOC_PIN6) |           \
                                     PIN_MODE_INPUT(GPIOC_PIN7) |           \
                                     PIN_MODE_INPUT(GPIOC_PIN8) |           \
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
#define VAL_GPIOF_ODR               (PIN_ODR_HIGH(GPIOF_OSC_IN) |           \
                                     PIN_ODR_HIGH(GPIOF_OSC_OUT) |          \
                                     PIN_ODR_HIGH(GPIOF_PIN2) |             \
                                     PIN_ODR_HIGH(GPIOF_PIN3) |             \
                                     PIN_ODR_HIGH(GPIOF_PIN4) |             \
                                     PIN_ODR_HIGH(GPIOF_PIN5) |             \
                                     PIN_ODR_HIGH(GPIOF_PIN6) |             \
                                     PIN_ODR_HIGH(GPIOF_PIN7) |             \
                                     PIN_ODR_HIGH(GPIOF_PIN8) |             \
                                     PIN_ODR_HIGH(GPIOF_PIN9) |             \
                                     PIN_ODR_HIGH(GPIOF_PIN10) |            \
                                     PIN_ODR_HIGH(GPIOF_PIN11) |            \
                                     PIN_ODR_HIGH(GPIOF_PIN12) |            \
                                     PIN_ODR_HIGH(GPIOF_PIN13) |            \
                                     PIN_ODR_HIGH(GPIOF_PIN14) |            \
                                     PIN_ODR_HIGH(GPIOF_PIN15))
#define VAL_GPIOF_AFRL              (PIN_AFIO_AF(GPIOF_OSC_IN, 0) |         \
                                     PIN_AFIO_AF(GPIOF_OSC_OUT, 0) |        \
                                     PIN_AFIO_AF(GPIOF_PIN2, 0) |           \
                                     PIN_AFIO_AF(GPIOF_PIN3, 0) |           \
                                     PIN_AFIO_AF(GPIOF_PIN4, 0) |           \
                                     PIN_AFIO_AF(GPIOF_PIN5, 0) |           \
                                     PIN_AFIO_AF(GPIOF_PIN6, 0) |           \
                                     PIN_AFIO_AF(GPIOF_PIN7, 0))
#define VAL_GPIOF_AFRH              (PIN_AFIO_AF(GPIOF_PIN8, 0) |           \
                                     PIN_AFIO_AF(GPIOF_PIN9, 0) |           \
                                     PIN_AFIO_AF(GPIOF_PIN10, 0) |          \
                                     PIN_AFIO_AF(GPIOF_PIN11, 0) |          \
                                     PIN_AFIO_AF(GPIOF_PIN12, 0) |          \
                                     PIN_AFIO_AF(GPIOF_PIN13, 0) |          \
                                     PIN_AFIO_AF(GPIOF_PIN14, 0) |          \
                                     PIN_AFIO_AF(GPIOF_PIN15, 0))


/*
 * USB bus activation macro, required by the USB driver.
 */
#define usb_lld_connect_bus(usbp) board_usb_connect()

/*
 * USB bus de-activation macro, required by the USB driver.
 */
#define usb_lld_disconnect_bus(usbp) board_usb_disconnect()

#if !defined(_FROM_ASM_)
#ifdef __cplusplus
extern "C" {
#endif
  void boardInit(void);
  void board_usb_connect(void);
  void board_usb_disconnect(void);
#ifdef __cplusplus
}
#endif
#endif /* _FROM_ASM_ */

#endif /* _BOARD_H_ */
