vooon/miniecu/fw/adc/adc_flow.c

/**
 * @file       adc_flow.c
 * @brief      ADC Flow sensor subtask
 * @author     Vladimir Ermakov Copyright (C) 2014.
 * @see        The GNU Public License (GPL) Version 3
 */
/*
 * This program is free software; you can redistribute it and/or modify
 * it under the terms of the GNU General Public License as published by
 * the Free Software Foundation; either version 3 of the License, or
 * (at your option) any later version.
 *
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
 * You should have received a copy of the GNU General Public License along
 * with this program; if not, write to the Free Software Foundation, Inc.,
 * 59 Temple Place, Suite 330, Boston, MA 02111-1307 USA
 */

#include "th_adc.h"
#include "param_table.h"
#include <math.h>

/* -*- parameters -*-  */
bool gp_flow_enable;
float gp_flow_v0;		// V
float gp_flow_dia1;		// mm
float gp_flow_dia2;		// mm
float gp_flow_cd;
float gp_flow_ro;		// kg/m3
int32_t gp_flow_tank_ml;	// mL
int32_t gp_flow_low_ml;		// mL


/* -*- private variabled -*- */
static float m_C;
static float m_A2;		// m2
static double m_total_used_ml;
static float m_flow_mlsec;	// mL3/sec

#define FLOW_MAXV	3.3	// V
#define MP3V5004DP_MINP	0.0	// Pa
#define MP3V5004DP_MAXP	3920.0	// Pa


/* -*- global -*- */

void on_change_flow_params(struct param_entry *p ATTR_UNUSED)
{
	m_A2 = M_PI * powf(gp_flow_dia2 / 1000.0, 2) / 4.0;
	m_C = gp_flow_cd / sqrtf(1 - powf(gp_flow_dia2 / gp_flow_dia1, 4));
}

/**
 * Return current flow [mL/min]
 */
bool flow_get_flow(uint32_t *out)
{
	/* out in 0.1 mL/min */
	*out = m_flow_mlsec * 1000000.0;
	return gp_flow_enable;
}

/**
 * Return fuel usage [mL]
 */
uint32_t flow_get_used_ml(void)
{
	return m_total_used_ml;
}

/**
 * Check fuel reserve
 * @return true if fuel level is LOW
 */
bool flow_check_fuel(void)
{
	if (gp_flow_low_ml == 0.0 || gp_flow_tank_ml == 0.0)
		return false;

	return (gp_flow_tank_ml - m_total_used_ml) <= gp_flow_low_ml;
}

/**
 * Calculate fuel gauge (if possible)
 *
 * @param[out] *out calculated value
 * @return true if calculation possible
 */
bool flow_get_remaining(uint32_t *out)
{
	if (gp_flow_tank_ml == 0.0)
		return false;

	float rem_ml = gp_flow_tank_ml - m_total_used_ml;
	if (rem_ml > gp_flow_tank_ml)	rem_ml = gp_flow_tank_ml;
	else if (rem_ml < 0)		rem_ml = 0;

	*out = arduino_map(rem_ml, 0.0, gp_flow_tank_ml, 0, 100);
	return true;
}

void adc_handle_flow(void)
{
	static bool is_inited = false;
	if (!is_inited) {
		on_change_flow_params(NULL);
		is_inited = true;
	}

	if (!gp_flow_enable)
		return;

	/* Notes: equation for orifice plate from
	 * http://en.wikipedia.org/wiki/Orifice_plate
	 */

	float dP = arduino_map(adc_getflt_flow(), gp_flow_v0, FLOW_MAXV, MP3V5004DP_MINP, MP3V5004DP_MAXP);
	float Q = m_C * m_A2 * sqrtf(2.0 * dP / gp_flow_ro);

	m_flow_mlsec = Q * 1e6;

	/* TODO: total fuel used calculation */
}
