vooon/miniecu/(commit log)

2014-01-20 add connectors (made from bt_con-jst-xh.lbr)
2014-01-20 add isolator, esd lib
    [miniecu.sch]
2014-01-20 add VN5E025 smart switch
2014-01-21 first schematic.
    [miniecu.sch]
2014-01-21 change iv esd supply +3V3->AVCC
    [miniecu.sch]
2014-01-21 initial pcb: placing done
    [miniecu.brd]
2014-01-21 use two resistors in voltage divider
    [miniecu.brd, miniecu.sch]
2014-01-22 pcb: routing done
    [miniecu.brd, miniecu.sch]
2014-01-22 add miniECU logo to board
    larger logo xcf.
    rename miniecu-con.lbr to miniecu.lbr, place symlink for sch.
    [miniecu.sch]
2014-01-22 brd: place components >Name
    [miniecu.brd]
2014-01-22 pcb: add bottom silk
    [miniecu.brd]
2014-01-22 pcb: gerbers for IDTEAD Studio
    [miniecu.GBL, miniecu.GBO, miniecu.GBP, miniecu.GBS, miniecu.GTL, miniecu.GTO, miniecu.GTP, miniecu.GTS]
2014-01-23 sch: change LDO MCP1700 (6V max) -> MCP1703 (16V max) in the same package
    Fix LDO ceramic capasitance from 4.7 µF to 1.0 µF (MCP1703 DS)
    [miniecu.brd, miniecu.sch]
2014-01-23 sch: minimize BOM (by resistor values)
    [miniecu.brd, miniecu.sch]
2014-01-23 hw: release hw v1b, update gerbers
    [miniecu.brd, miniecu.sch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]
2014-01-30 hw: release v1c & update gerbers
    changes from v1b:
    - Use rounded corners.
    - Add one GND drill.
    [miniecu.GBL, miniecu.GBO, miniecu.GBP, miniecu.GBS, miniecu.GTL, miniecu.GTO, miniecu.GTP, miniecu.GTS]
2014-02-02 fw: Add board defenition, stub project
    New dirs:
    - boards -- chibios board definition + project defenition (makefile)
    - fw -- firmware sources
2014-02-07 tools: Add pktview tool
    Simple tool for decoding all pakets from device
2014-02-07 fw: add message decoding for TimeReference
2014-02-08 fw: fix pbstx rx
    [pbstx.c, th_comm.c]
2014-02-09 fw: port to ChibiOS/Nil 3.0 (dev version)
    TODO: Simulator broken.
    Current kernel_3_dev supports only ARM arch.
    Need to port SIMIA32 to new ChibiOS version.
    [board.c, chconf.h, fw_common.h, fw_config.h, halconf.h, main.c, mcuconf.h, pbstx.c]
2014-02-14 remove simulator target
    Currently ChibiOS 3.0 don't support simulator target.
    Instead of porting simulator i've decided use vl-discovery for testing.
2014-02-15 fw: add stm32vl-discovery target
    Use discovery board for prototyping.
2014-02-15 fw: switch to ChibiOS/Nil only.
    And some debug stuff for VL-Discovery.
2014-02-25 fw: commit debug code before reverting to ChibiOS/RT 2.x
    Some very strange bugs with serial io in ChibiOS/Nil 3.
    And we dicide move to STM32 F3 (it's only x2 price of F0 in TSOP-48, but much more
    horse power).
    [fw_common.h, main.c, pbstx.c, th_comm.c]
2014-02-26 fw: revert ChibiOS/RT 2.x
    Revert to more stable 2.x branch.
    PBSTX now works as planned.
    NOTES: seems STM32F050F4 to small, we replace it with STM32F373 in next
    hw release.
    [chconf.h, fw_common.h, fw_config.h, halconf.h, main.c, mcuconf.h, pbstx.c, th_comm.c]
2014-02-26 fw: add led indication on hw_v1c.
    NOTE: almost all flash used :(
2014-02-26 fw: use main as idle thread
2014-02-27 hw: save hw_1.0c board
    [miniecu-v1.0c.brd, miniecu-v1.0c.sch]
2014-02-27 hw: add stm32f373 library
2014-03-01 hw: add DS for new mcu and pressure sensor
2014-03-01 hw: replace mcu
    [miniecu.brd, miniecu.sch]
2014-03-06 fw: temp. switch to flash25 test app
2014-03-07 fw: update flash driver
2014-03-08 hw: add library for Murata CSTCE resonators
    [miniecu.brd, miniecu.sch]
2014-03-09 hw: do half connections of v2
    [miniecu.brd, miniecu.sch]
2014-03-09 hw: add SWD, EXT connectors; sch done
    [miniecu.brd, miniecu.sch]
2014-03-09 hw: route top half
    [miniecu.brd, miniecu.sch]
2014-03-09 hw: hw_2.0a routed
    [miniecu.brd]
2014-03-09 hw: release hw_2.0a
    [miniecu.GBL, miniecu.GBO, miniecu.GBP, miniecu.GBS, miniecu.GTL, miniecu.GTO, miniecu.GTP, miniecu.GTS]
2014-03-12 hw: Update description, add BOM in CSV
    [miniecu.bom.csv]
2014-04-17 fw: Add ADC thread
    Currently it does nothing.
2014-04-17 fw: drop ChibiOS/Nil support, fix LED initialization
    [alert_led.c, alert_led.h, main.c]
2014-04-20 fw: SDADC test passed, TODO fix sma_*()
    [board.h, halconf.h, mcuconf.h, th_adc.c, th_comm.c]
2014-04-21 fw: ADC: remove SMA and setup events for update.
    TODO: add conversion logick to adc thread (some conversion done by
    cb's).
2014-04-23 fw: Add RTC module, enable TimeReference
2014-04-23 fw: Add Vbat to Status
    TODO: battery remaining calculation based on BATT_TYPE & BATT_CELLS
    and voltage.
2014-04-23 fw: Fix battery cutoff values
    [adc_batt.c]
2014-04-24 fw: Implement battery gauge for NiMH (and NiCd)
2014-04-24 fw: Enable NTC term input, temperature field in Status
2014-05-08 Switch ChibiOS to stable branch (2.6.x)
2014-05-08 fw: Implement USB serial for configuration & log download
    NOTE: USB not isolated from ignition battery! Do not enable ign power!
2014-05-25 fw: Add memory dump command
    Issues #5, #6.
    [memdump.c, pbstx.py, th_comm.c]
2014-05-25 fw: Send ADC RAW voltages if required
    Fix #6.
    [th_adc.c, th_adc.h, th_comm.c]
2014-05-25 fw: Fix USB reconnect
    Fix #7.
    [board.c, board.h]
2014-05-26 fw: RPM module
    Fix #2.
    [board.h, main.c, th_comm.c, th_rpm.c, th_rpm.h]
2014-05-30 tools: Fix PBStx __die__() exception
    New: memdump tool (WIP)
    [pbstx.py]
2014-05-30 fw: Fix FLASH_CS pin
    [board.h]
2014-05-30 fw: Initial flash_log module.
    New: Memdump flash.
    Fix #5.
    [fw_common.h, main.c, memdump.c, mtd_config.h, th_comm.c, th_flash_log.h]
2014-05-30 fw: Command module (initial)
    Currently supports only Ignition and Starter operations.
    Fix: #10.
    [main.c, th_adc.c, th_comm.c, th_command.h, th_rpm.c]
2014-05-31 fw: Response to config save/load/erase
    TODO: wait end of operation (condvar broken)
    Part of #4.
    [pbstx.c, th_comm.c, th_comm.h, th_flash_log.h]
2014-06-01 fw: Save/Load/Erase parameters done.
    Fix #4.
    [mtd_config.h]
2014-06-02 fw: Add ESTOP in command module
    Small changes: don't answer to broadcast commands,
    add python protoc generator.
    Fix #10.
    [th_comm.c]
2014-06-02 fw: Serial baudrate change
    Fix #14.
    [th_comm.c]
2014-06-02 fw: OILP ADC submodule.
    Currently only two modes: Disabled, NTC10k (secondary engine termometer).
    Fix #11. And fix negative engine temperature.
    [adc_oilp.c, adc_therm.c, th_adc.c, th_adc.h, th_comm.c]
2014-06-04 fw: FLOW submodule
    TODO: calculate total_used_ml.
    Fix #3.
    [adc_batt.c, adc_flow.c, fw_common.h, th_adc.c, th_adc.h, th_comm.c]
2014-09-23 hw: Release hw_2.0a.
    [miniecu-v2.0a.brd, miniecu-v2.0a.sch]
2014-09-23 fw: Remove board file for hw_1.0, it never works.
2014-09-23 Upgrade board files to ChibiOS 3.
    Firmware now is broken.
    [board.c, board.h, chconf.h, halconf.h, mcuconf.h]
2014-09-23 fw: Build failed at flash25 module.
    [chconf.h, main.c]
2014-09-23 Upgrade for ChibiOS v3. Builds.
    RTC support broken (no HAL driver).
    [alert_led.c, board.h, chconf.h, fw_common.h, mcuconf.h, memdump.c, pbstx.c]
2014-09-24 fw: Refactoring PBStx module to frame-only proto.
    New proto: STX, SEQ, LEN_LSB, LEN_MSB, PAYLOAD..., CRC16_LSB, CRC16_MSB
2014-09-24 tools: Fix CRC16 calculation.
    crcmod provide wrong values, so i port NuttX crc16 lib.
    [pbstx.py, xmodem_crc16.py]
2014-09-26 fw #20: fix compile
    [th_comm.c]
2014-09-29 fw #21: Use generated parameter table.
    Fix #21.
    [adc_batt.c, adc_flow.c, adc_oilp.c, adc_therm.c, serial1.c, th_adc.c, th_comm_pbstx.c]
2014-09-30 fw: Update ChibiOS (RTC dayofweek fix)
    [board.h]
2014-09-30 fw #16: remove memdump. Trying to find error source
    [command.c, main.c, memdump.c, th_comm_pbstx.c]
2014-09-30 Revert "fw #16: remove memdump. Trying to find error source"
    This reverts commit 99a6a58699dc0f2be96af036097401aef1622812.
    [command.c, main.c, memdump.c, th_comm_pbstx.c]
2014-09-30 fw: param load at startup almost done.
    Buggy stopper: param_load() freeze cpu if it called from main().
    So as workaroud i decide to load params in flash log thread.
    [ext_flash.c, main.c, rtc_time.c]
2014-09-30 fw: Move th_flash_log to subdir log. Add lib.mk.
    Now thread priorities and stack size defined in fw_config.h
2014-09-30 fw: Param loading on init workaround: start one-shot dyn thread.
    After few tests i discover that param_load() require 2 KiB stack for
    operation.
2014-10-03 #17: add param tab button handlers
2014-10-09 ccgui #17: Add sig-slot to param model.
2014-10-14 ccgui: fix strip draw eqations
    [gauge_meter.py]
2014-10-14 ccgui: draw screws
2014-10-16 ccgui: Remove unneded log prints from GtkGauge.
2014-10-16 pb: Revert TemperatureStatus to engine1,2.
    [th_comm_pbstx.c]
2014-10-16 fw: Add ported LowPassFilter2p from PX4.
    Will be used for ADC filtering.
2014-10-17 ccgui: Update temperature filed.
2014-10-17 fw: Add openocd target.
    But st-util (stlink) is simplier. Just do:
    ```
    $ st-util &
    $ arm-none-eabi-gdb build/miniecu_v2/miniecu_v2.elf
    tar ext :4242
    load
    run
    ```
2014-10-17 fw: Rewrite PRM back to callback. Fonund bug in icuGetPeriodX().
    Issue #23.
    [fw_config.h, th_rpm.c]
2014-10-18 fw: Enable ChibiOS debugging.
    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
    [chconf.h]
2014-10-18 ccgui #18: Enable io logging: now it not works because #22.
    [ccgui.py]
2014-10-18 fw #19: RPM module now works, but filter not useable.
2014-10-18 fw #19: Remove not working filter from th_rpm.
    Need to find usable filter algo for this data.
    [th_rpm.c]
2014-10-18 fw #19: Reenable ADC thread. Now works only ADC1 (cpu temp, vrtc).
2014-10-18 fw #19: Disable adc filters
2014-10-18 fw #19: Enable SDADC1: battery, temp, oilp inputs.
2014-10-18 fw #19: Enable SDADC3: bug in driver.
    Wrong rccEnable in adc_lld.c at line 447 (waiting upstream fix).
    [th_adc.c]
2014-10-18 fw: Switch ChibiOS mirror, i hope it updates soon
2014-10-22 ccgui: Fix #22: sqlite threading error.
    [sql_log.py]
2014-10-22 fw: changes for FLOW testing
2014-10-28 ccgui #18: Add switches to control IGNITION and STARTER power.
2014-10-28 fw #23: Send system time.
    Fix #23.
    [rtc_time.c, rtc_time.h, th_comm_pbstx.c]
2014-10-28 fw: Rename battery voltage trimmer parameter.
2014-10-28 fw: Send unfilered data, enable filters.
2014-10-31 tests: Add FLOW sensor test result data.
    Result: shows +0.2 ml/sec than claculated.
    Need tests with real motor.
    [flow_h1_1.csv, flow_h1_2.csv, flow_h1_3.csv, flow_h2_1.csv, flow_h2_2.csv, flow_h2_3.csv]
